Ransky3000/Automated-Voltage-Regulator-System/docs/Automated-Voltage-Regulator-System_Simulation/Voltage Regulator Actual picture/Front view.jpg

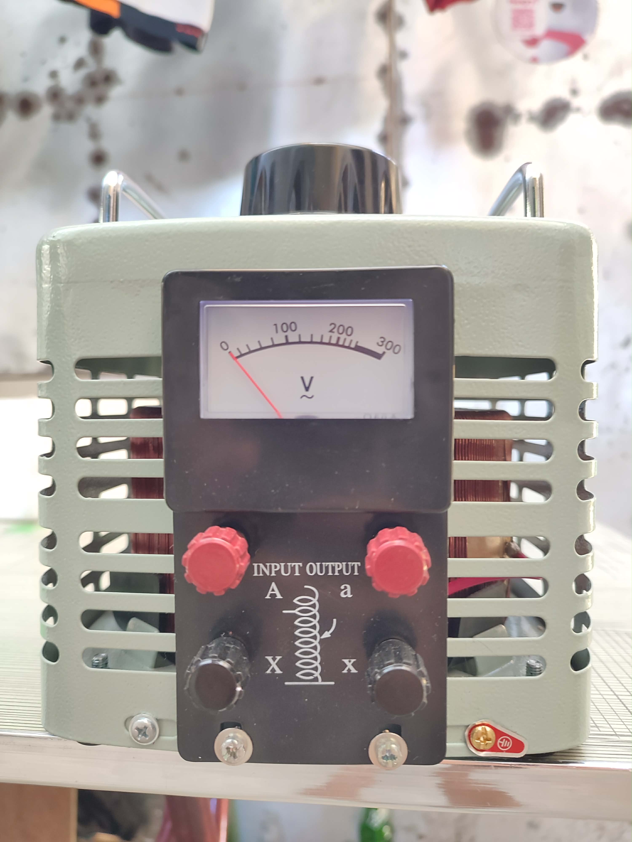
docs/Automated-Voltage-Regulator-System_Simulation/Voltage Regulator Actual picture/Front view.jpg
