Ransky3000/Automated-Voltage-Regulator-System/Option functions.pdf

Okay this is the overall system feature:

The First menu view on LCD 16x2:

1. Home: First line "[A] Set Voltage", Second line "[B] View Status"
1.1. Inside option [A]: First line "[A] Set target output", Second line "[B] <e.g. 50>", then enter display transitions to “Target output 50V”, then directed to [1.2 ].
1.2. Inside option [B]:First line "[A] Input", Second line "[B] Output"
1.2.1. Inside option [A]: First line "Voltage: <e.g 48V>”(Displays live voltage Input), 2nd line blank
1.2.2. Inside option [B]: First line "V: <e.g. 51V> I: <e.g. 5A>”, 2nd line “P: e.g. 255W”

NOTE: Key ‘A’ for next/enter/confirm and Key ‘D’ to go back on previous option in case you input wrong.
