Ransky3000/Automated-Voltage-Regulator-System/A recap/1.png

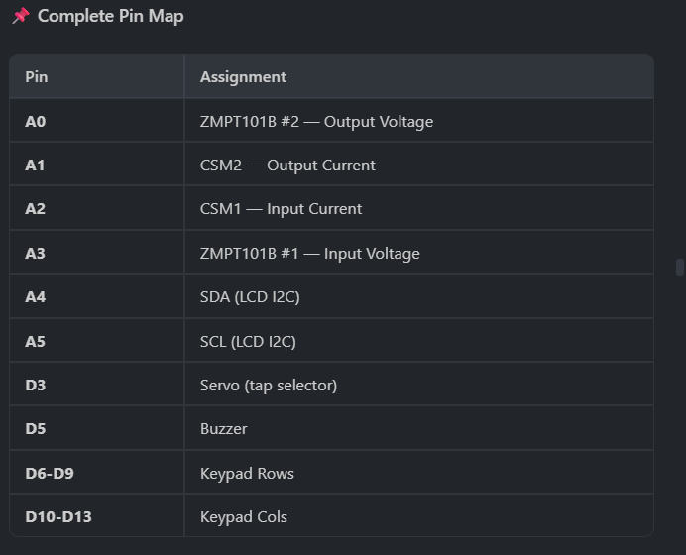
A recap/1.png
