Ransky3000/Automated-Voltage-Regulator-System/A recap/2.png

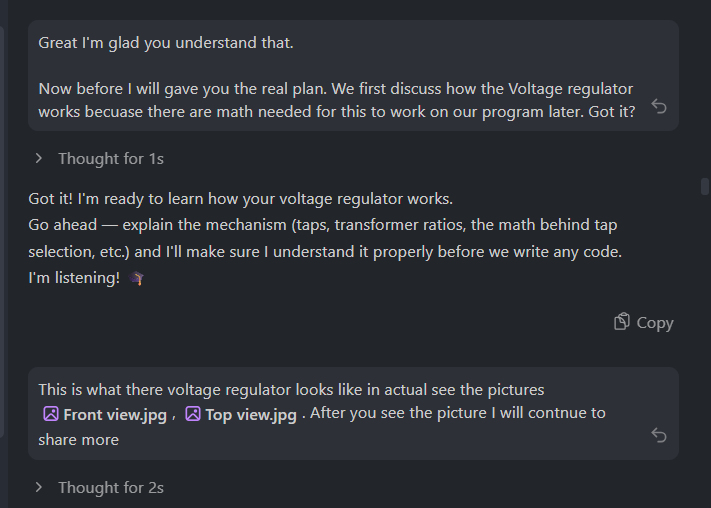
A recap/2.png
