Ransky3000/Automated-Voltage-Regulator-System/A recap/3.png

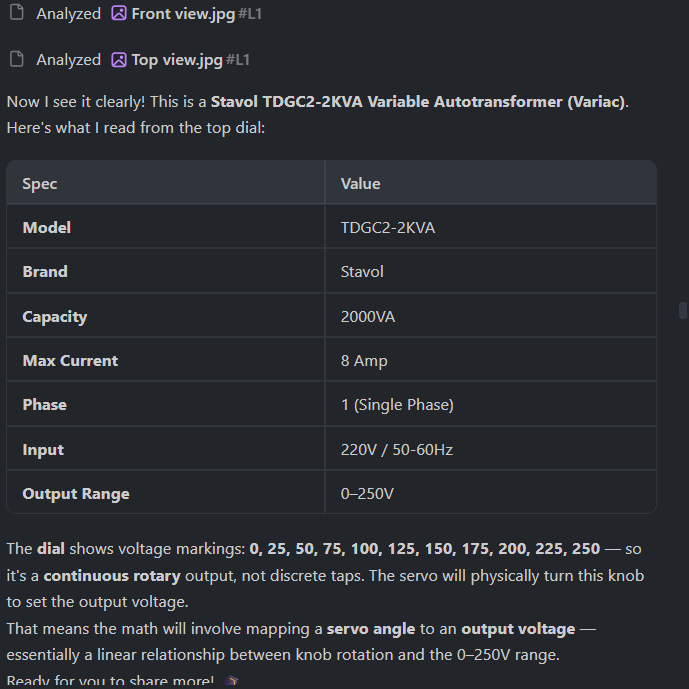
A recap/3.png
