Ransky3000/Automated-Voltage-Regulator-System/A recap/4.png

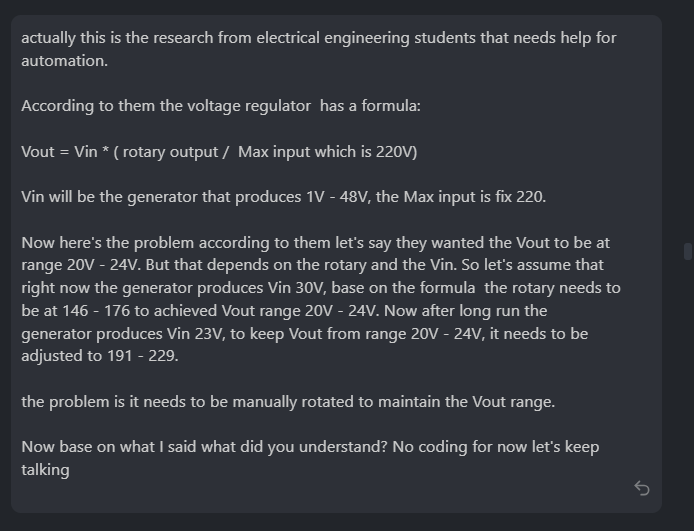
A recap/4.png
