Ransky3000/Automated-Voltage-Regulator-System/A recap/5.png

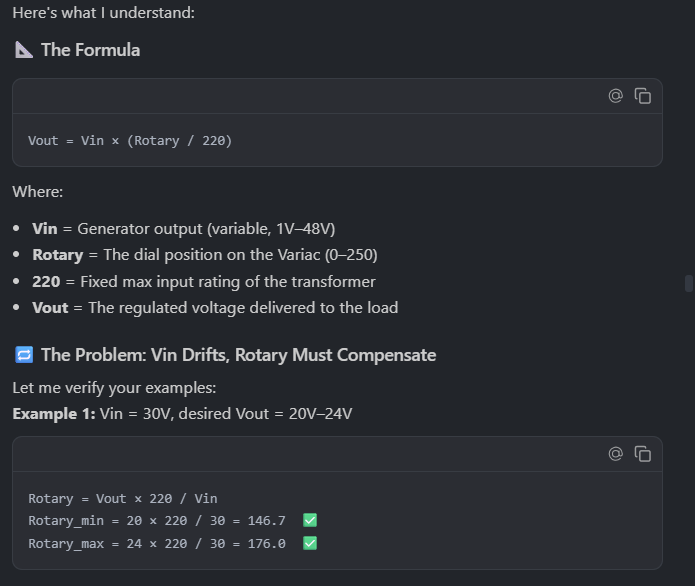
A recap/5.png
