Ransky3000/Automated-Voltage-Regulator-System/A recap/6.png

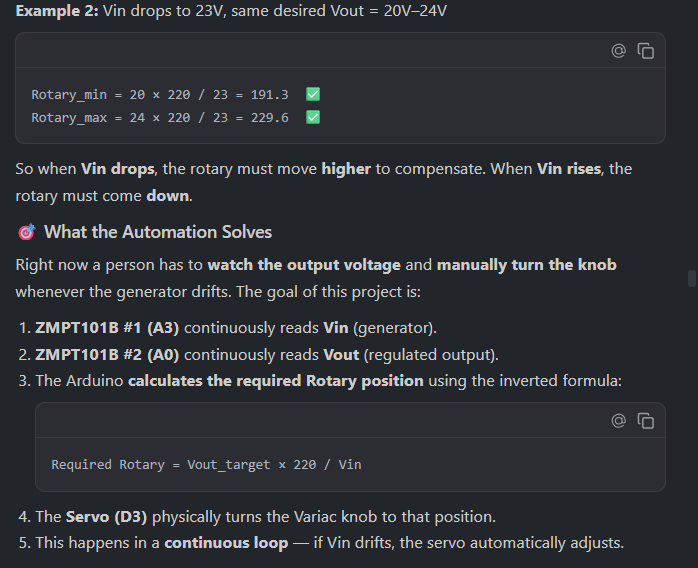
A recap/6.png
