Ransky3000/Automated-Voltage-Regulator-System/A recap/7.png

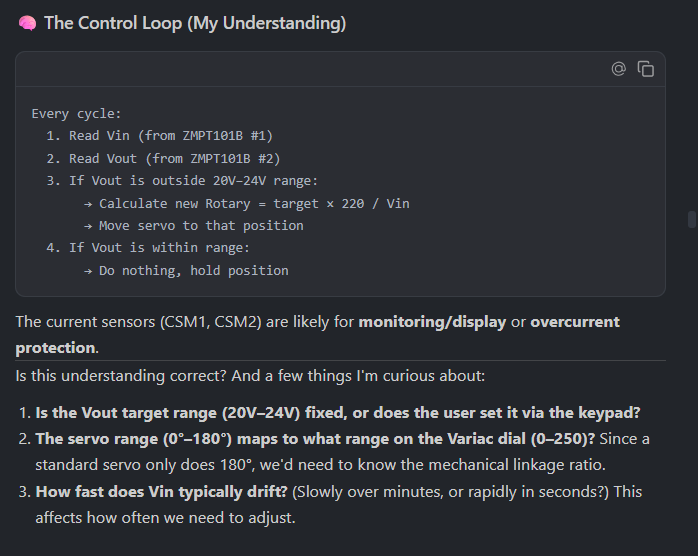
A recap/7.png
