Ransky3000/Automated-Voltage-Regulator-System/A recap/8.png

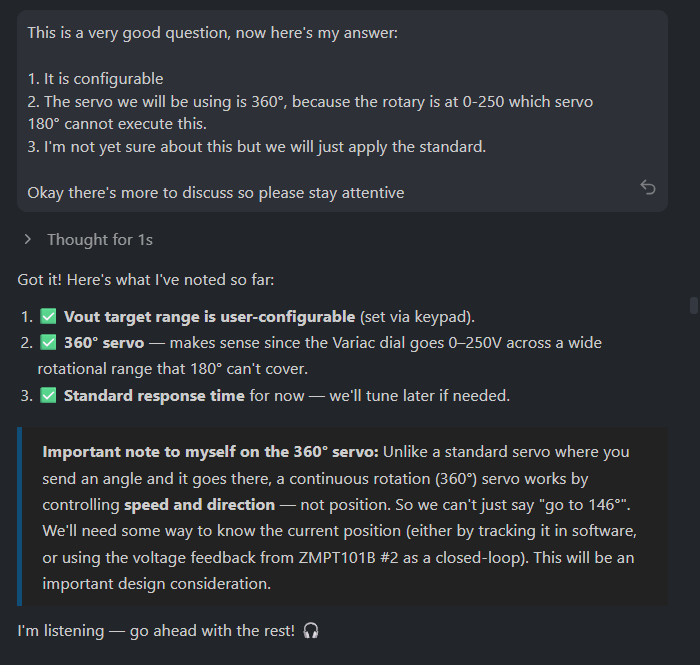
A recap/8.png
