Ransky3000/Automated-Voltage-Regulator-System/A recap/9.png

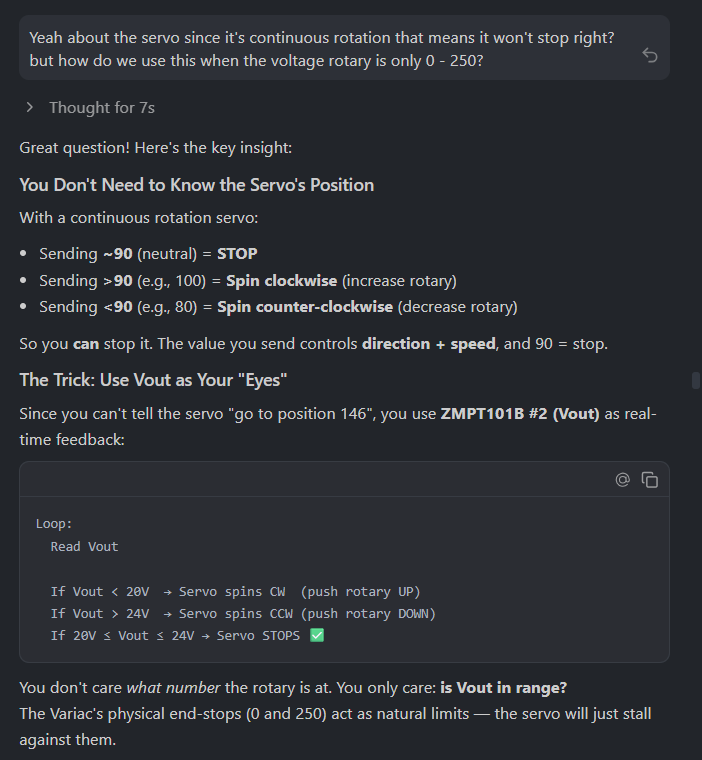
A recap/9.png
