Ransky3000/Automated-Voltage-Regulator-System/A recap/10.png

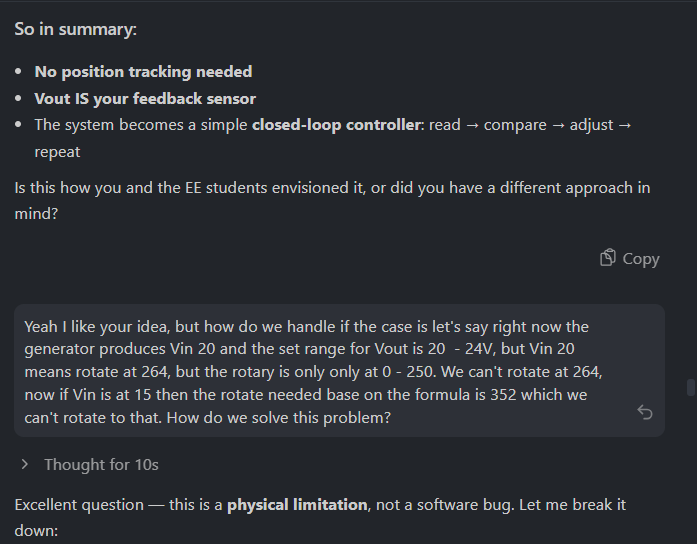
A recap/10.png
