Ransky3000/Automated-Voltage-Regulator-System/A recap/11.png

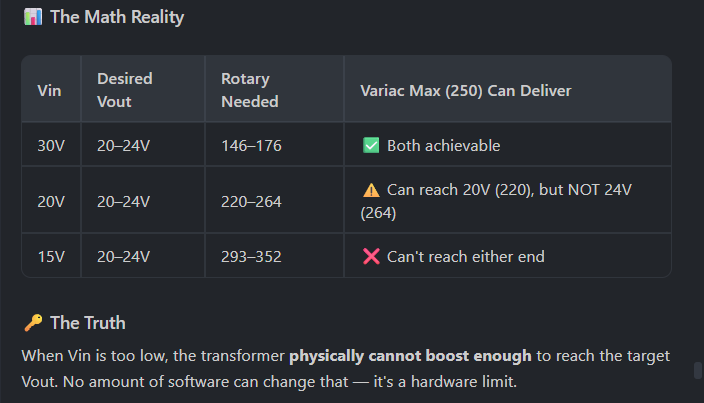
A recap/11.png
