Ransky3000/Automated-Voltage-Regulator-System/A recap/12.png

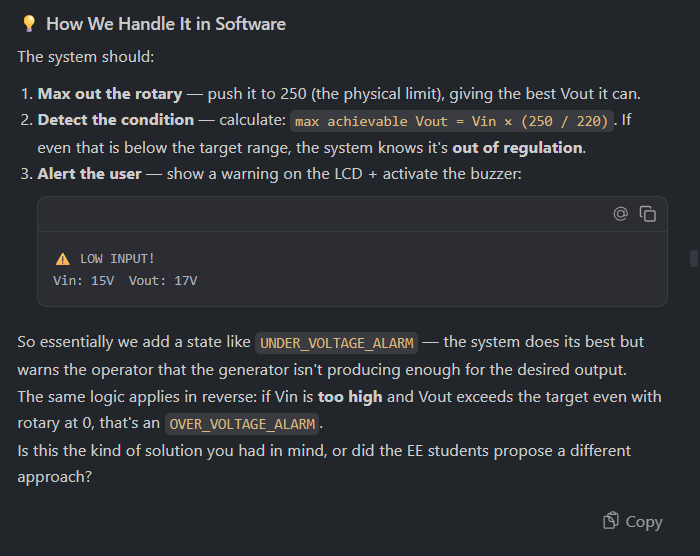
A recap/12.png
