Ransky3000/Automated-Voltage-Regulator-System/A recap/13.png

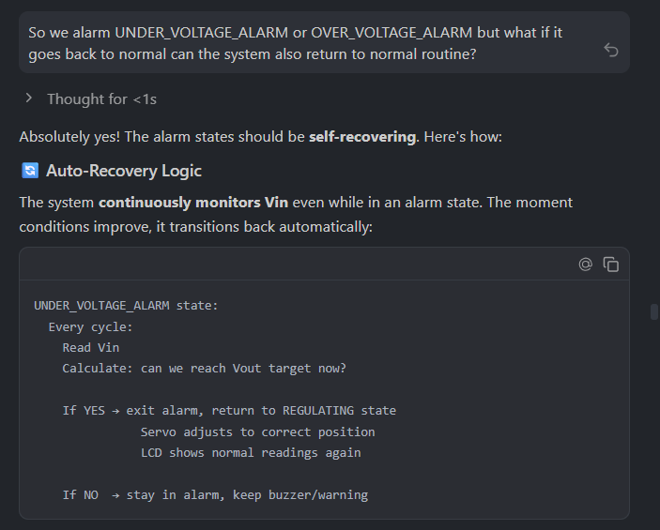
A recap/13.png
