Ransky3000/Automated-Voltage-Regulator-System/A recap/14.png

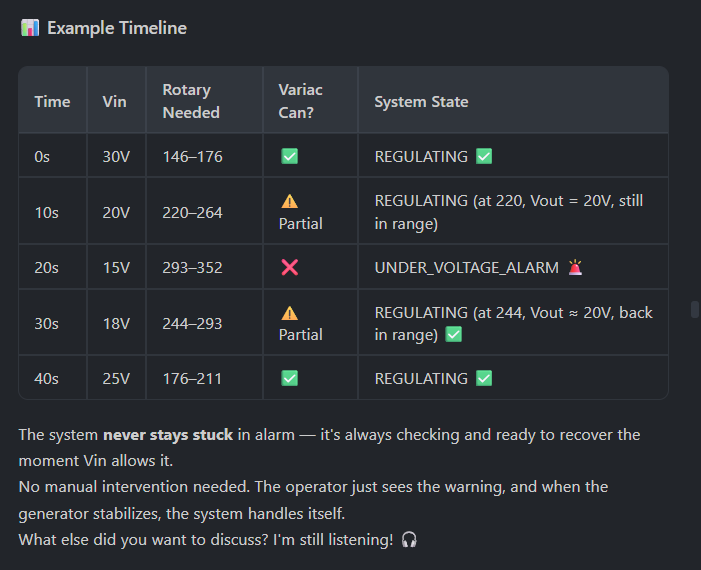
A recap/14.png
