Ransky3000/Automated-Voltage-Regulator-System/A recap/15.png

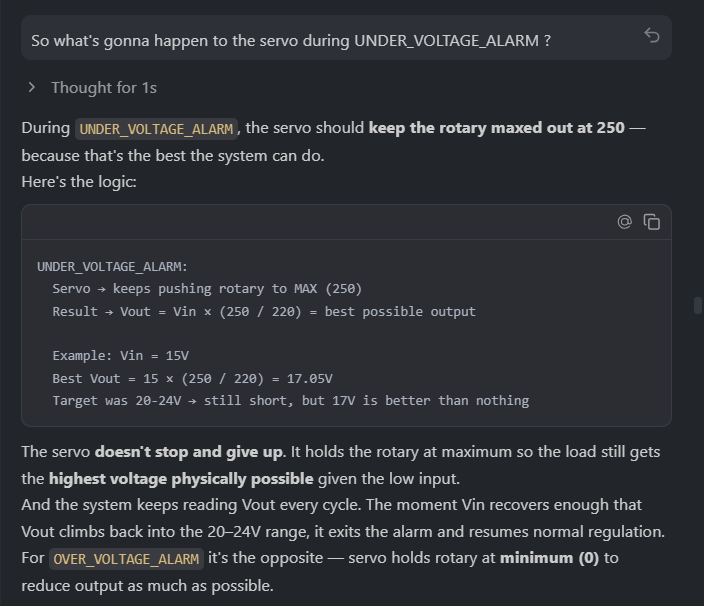
A recap/15.png
