Ransky3000/Automated-Voltage-Regulator-System/A recap/16.png

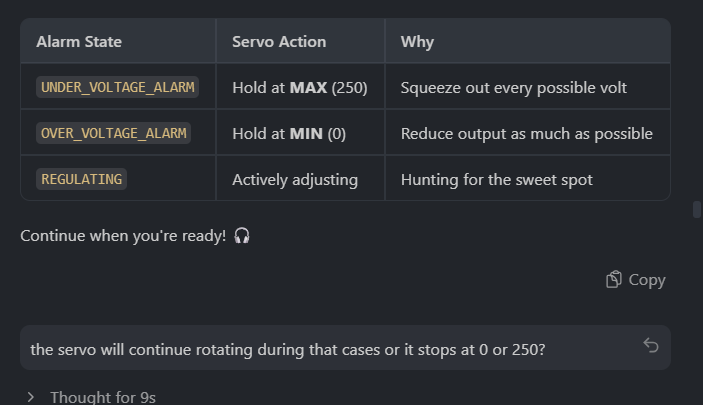
A recap/16.png
