Ransky3000/Automated-Voltage-Regulator-System/A recap/17.png

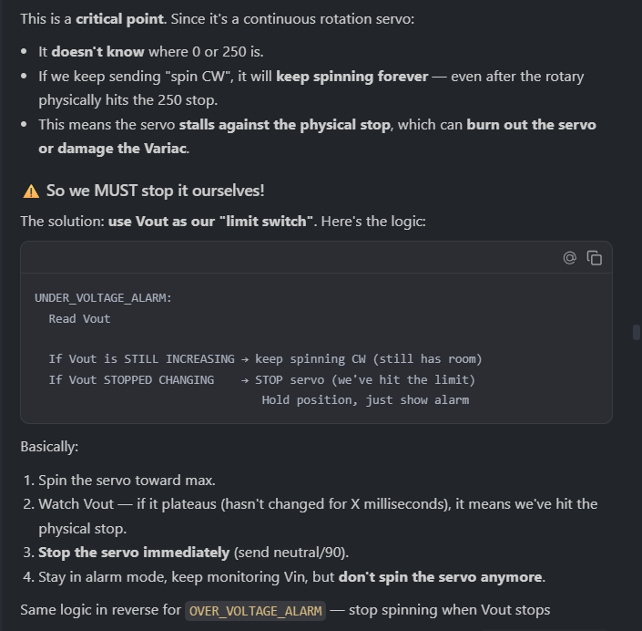
A recap/17.png
