Ransky3000/Automated-Voltage-Regulator-System/A recap/18.png

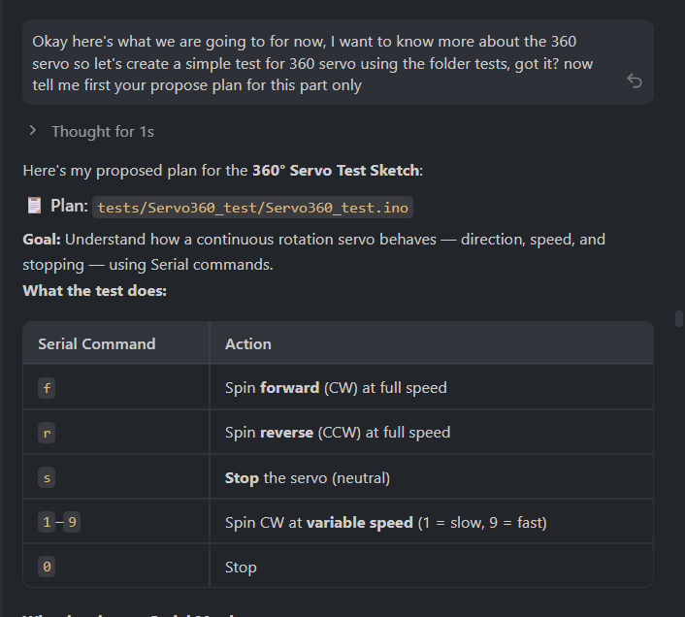
A recap/18.png
