Ransky3000/Automated-Voltage-Regulator-System/docs/Automated-Voltage-Regulator-System_Simulation/Screenshots/Full view.png

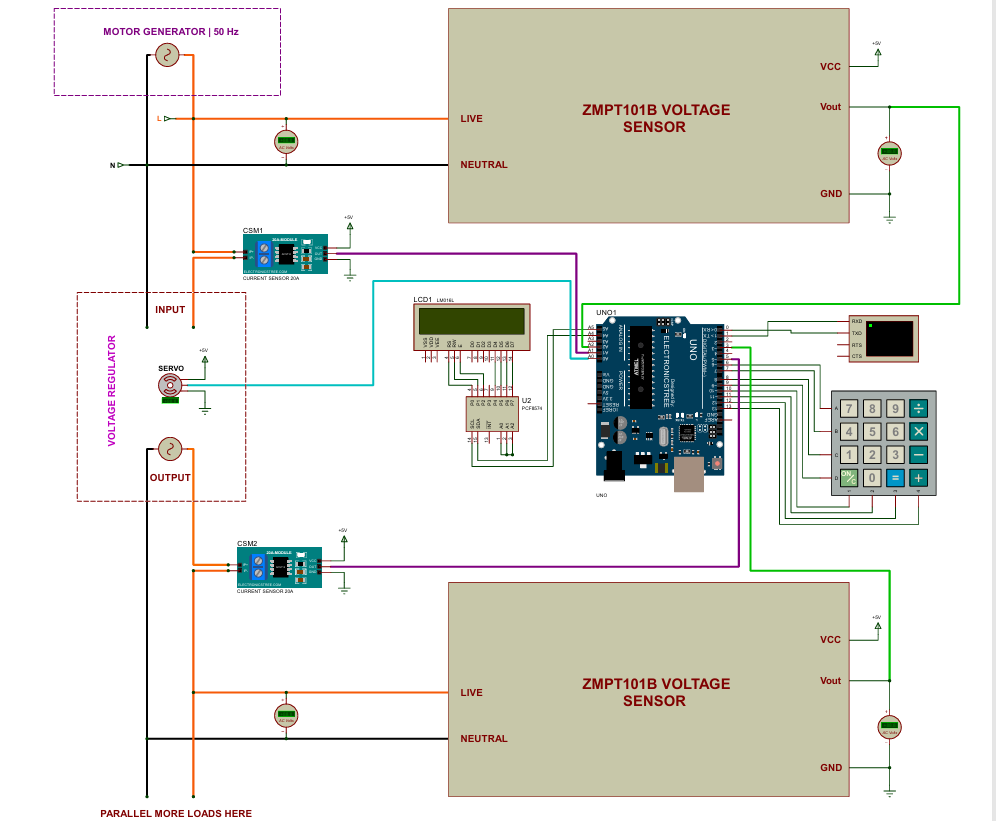
docs/Automated-Voltage-Regulator-System_Simulation/Screenshots/Full view.png
