Ransky3000/Automated-Voltage-Regulator-System/docs/Automated-Voltage-Regulator-System_Simulation/Screenshots/Mid layer.png

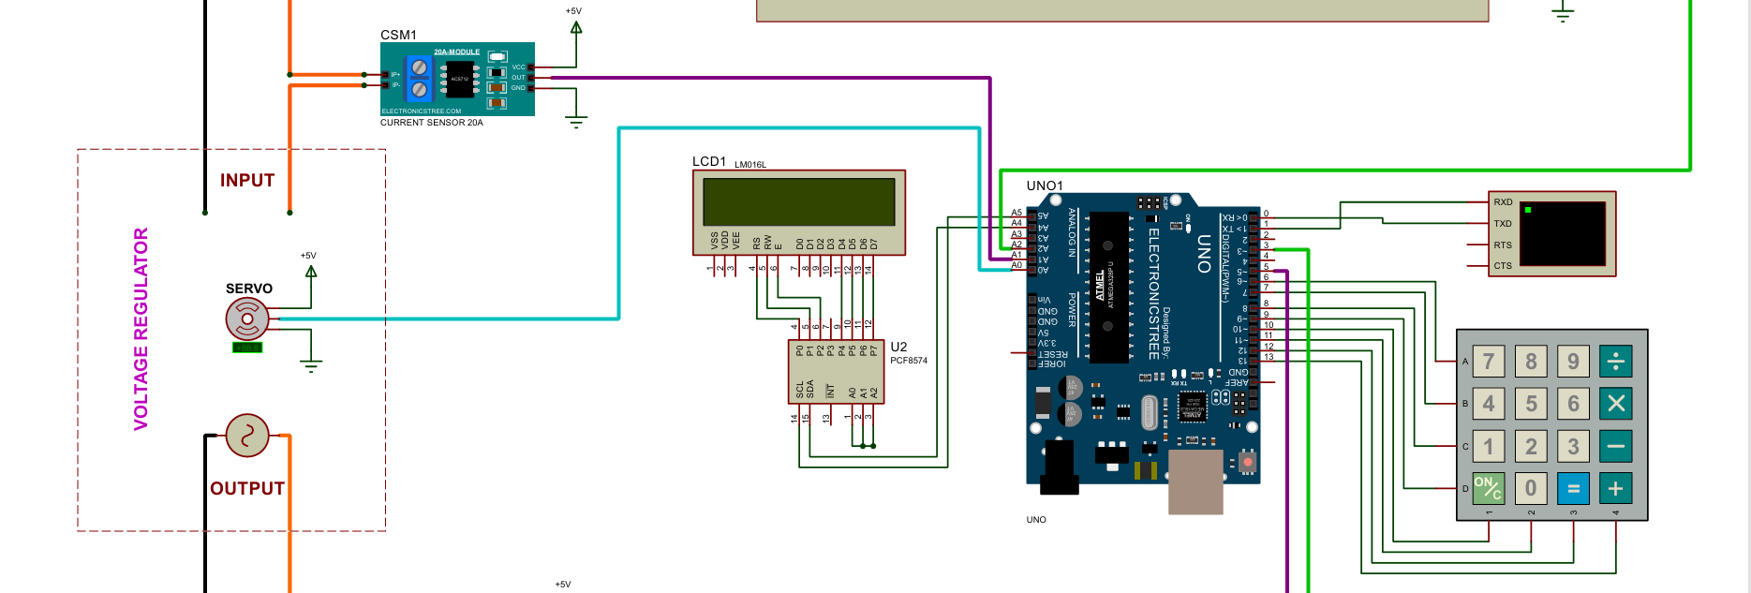
docs/Automated-Voltage-Regulator-System_Simulation/Screenshots/Mid layer.png
