Ransky3000/Automated-Voltage-Regulator-System/docs/Automated-Voltage-Regulator-System_Simulation/Voltage_regulator_Full_circuit.PDF

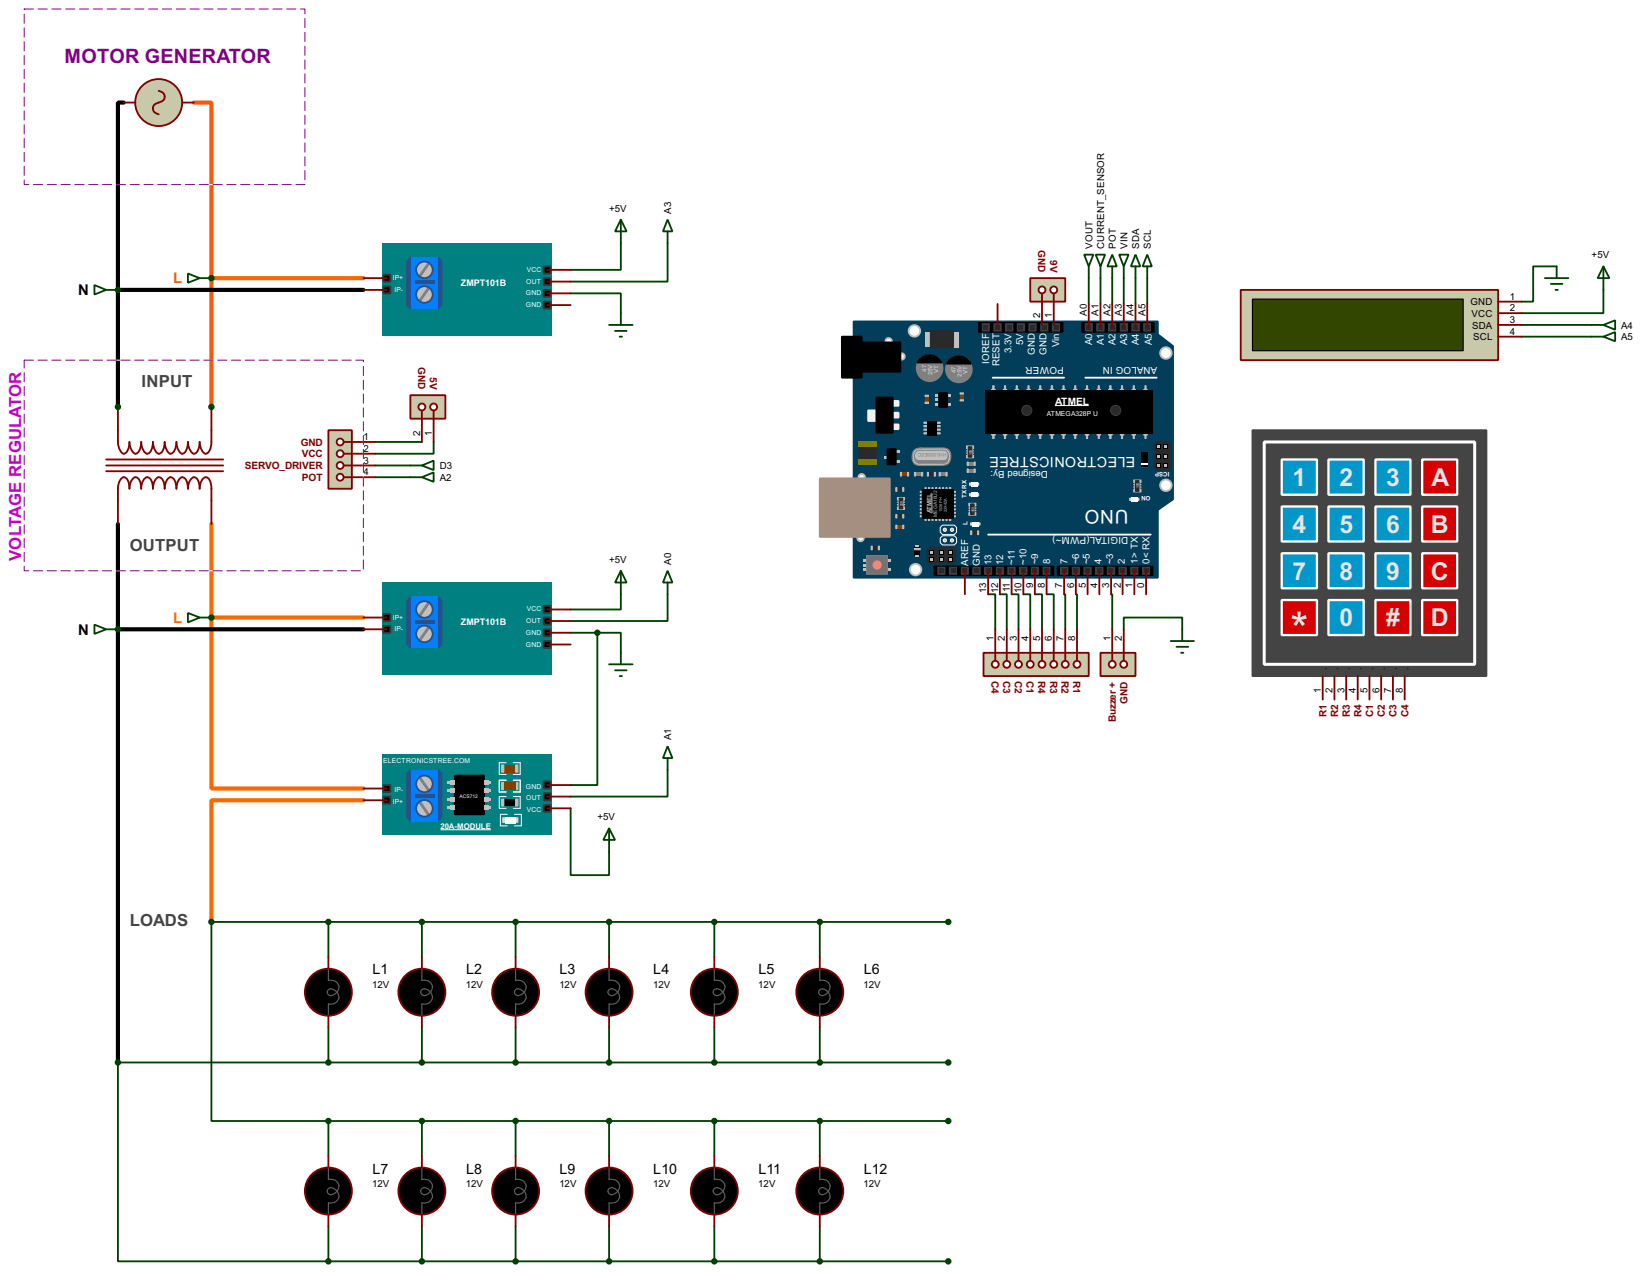
[picture p25: page 1]

VCC OUT GND GND
