Ransky3000/Automated-Voltage-Regulator-System/docs/Automated-Voltage-Regulator-System_Simulation/Automated-Voltage-Regulator-System_ACTUAL_CIRCUIT.PDF

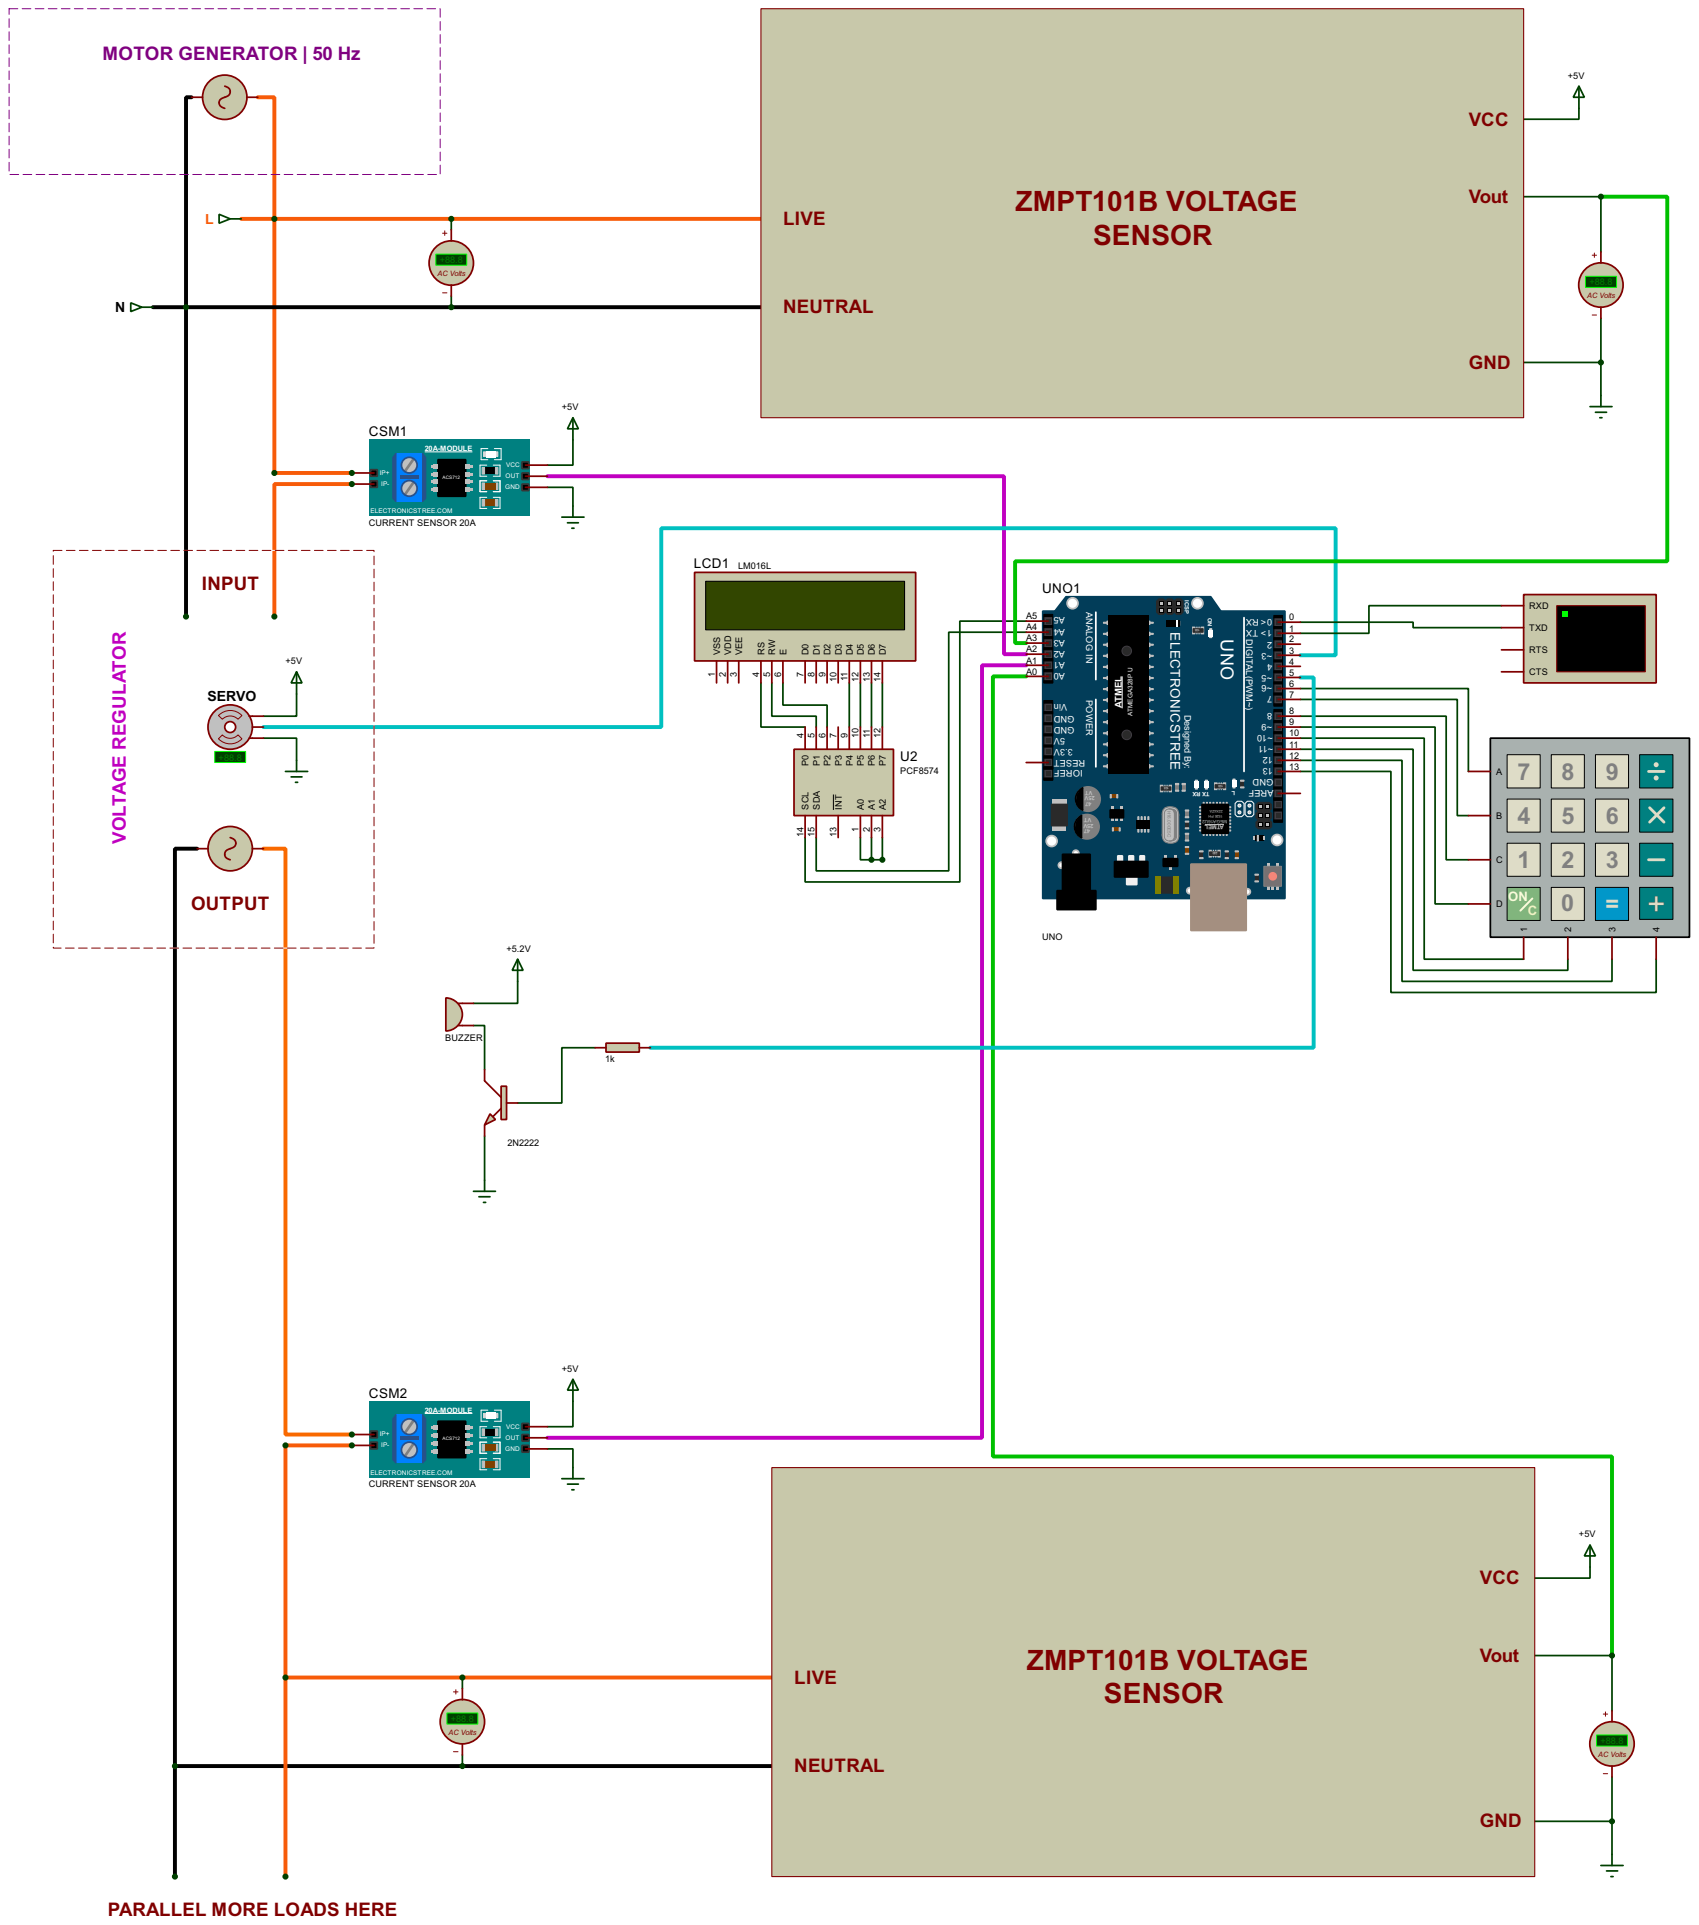
[picture p26: page 1]

ANALOG IN POWER 74V52 TV

10
11

PARALLEL MORE LOADS HERE
