Ransky3000/Automated-Voltage-Regulator-System/docs/Voltage_regulator_Actual_circuit.PDF

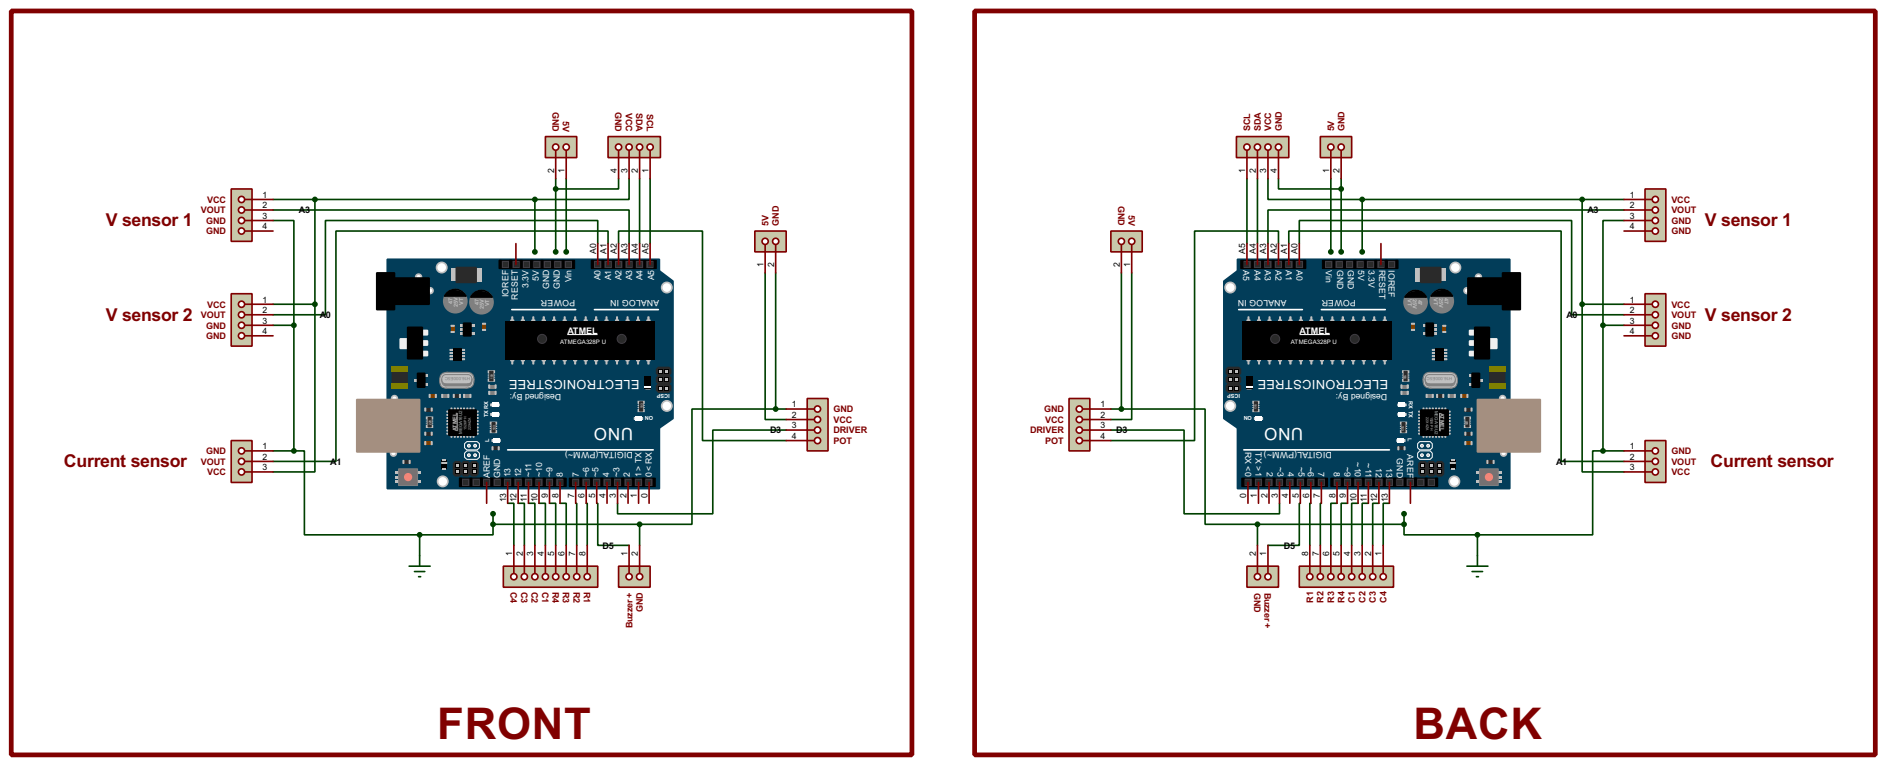
[picture p27: page 1]
