Ransky3000/Automated-Voltage-Regulator-System/docs/ZMPT101B_sensor_Simulation/zmpt101b.PDF

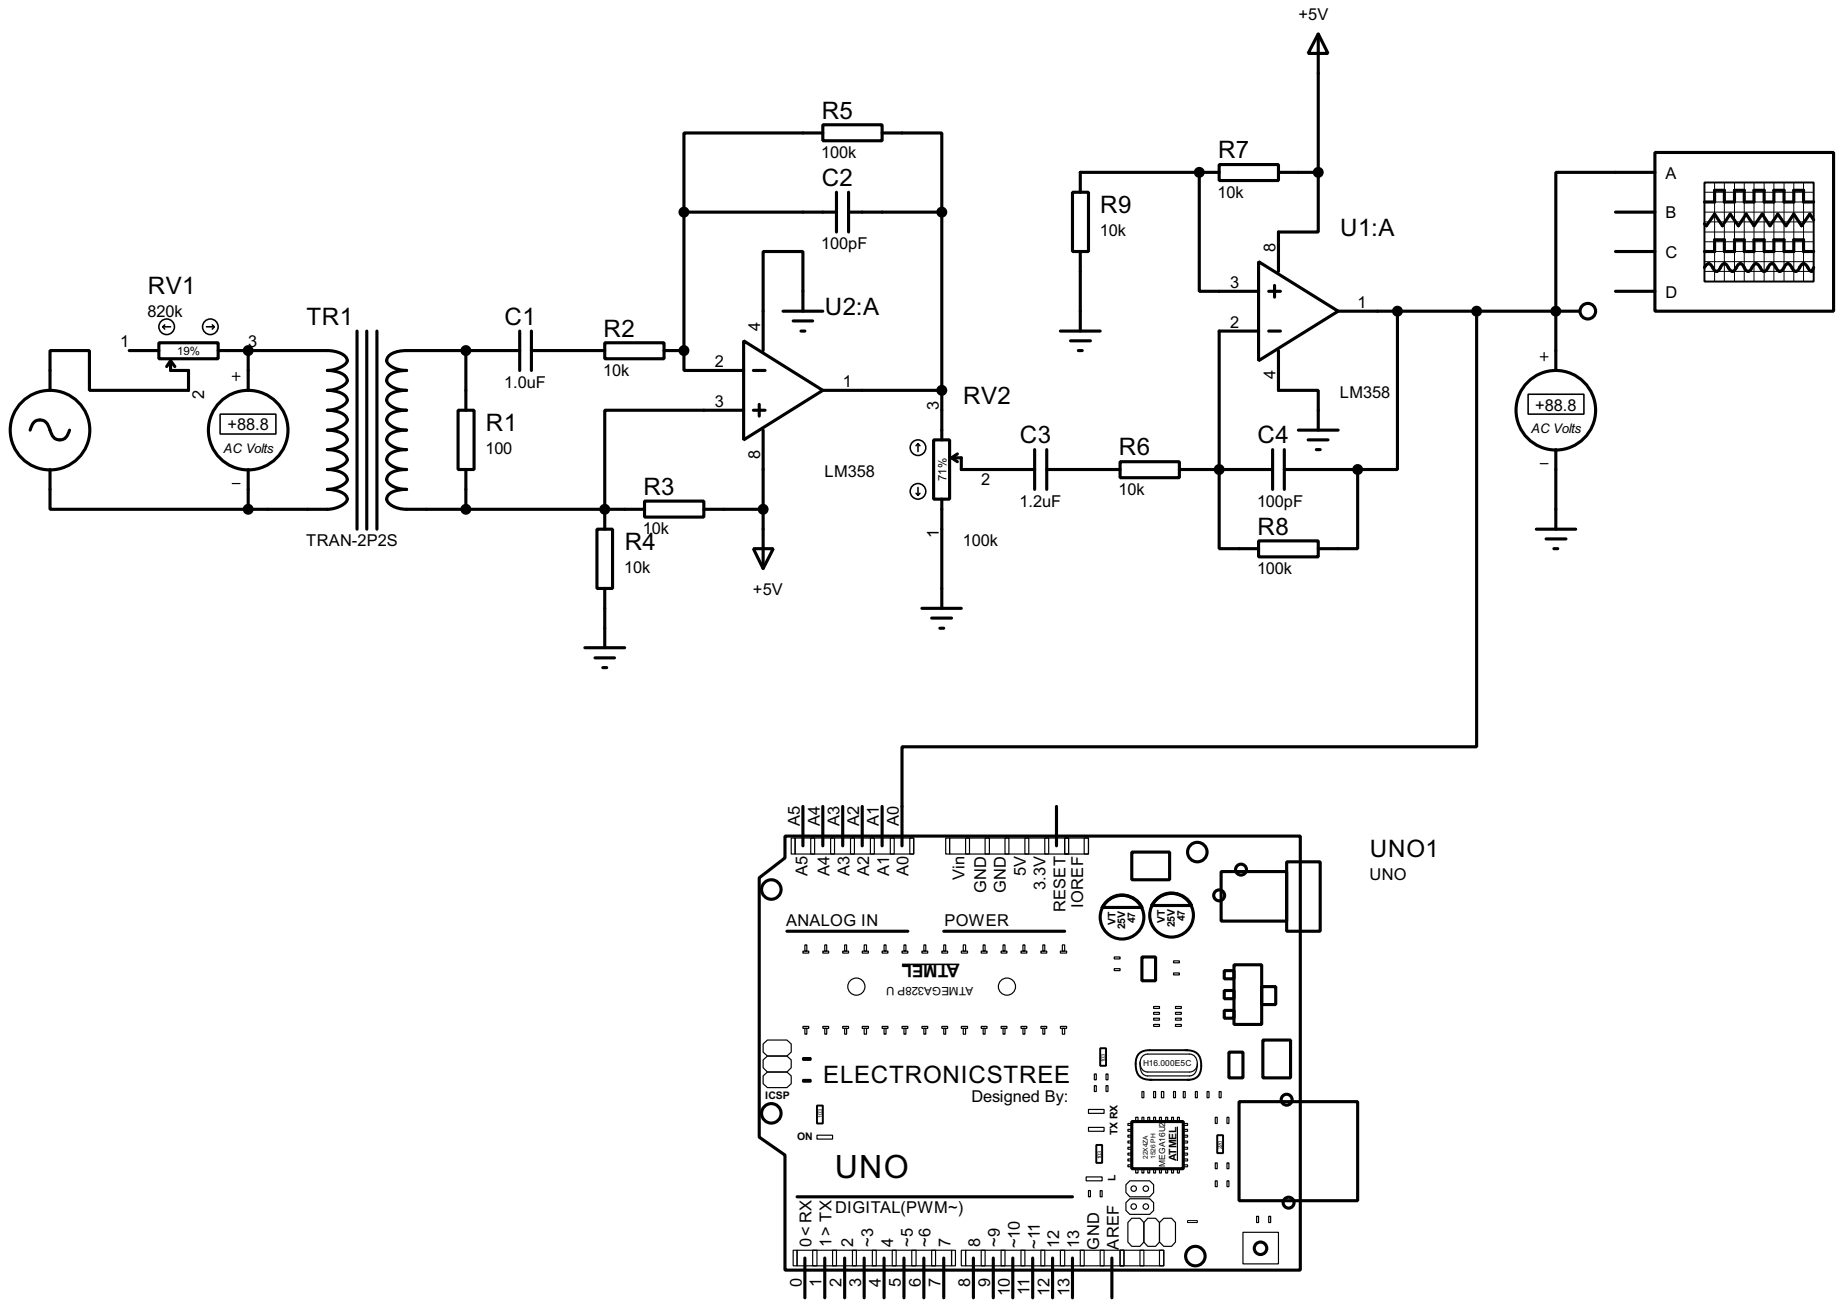
[picture p46: page 1]
