Ransky3000/Automated-Voltage-Regulator-System/(list of files, drawings)

Other design files:
docs/ZMPT101B_sensor_Simulation/zmpt101b.pdsprj
