Ransky3000/Automated-Voltage-Regulator-System/(commit log)

2026-02-11 feat: Add ZMPT101B AC voltage sensor driver with non-blocking RMS measurement, calibration, documentation, and a test sketch.
2026-02-12 feat: Add ZMPT101B voltage sensor driver with non-blocking RMS measurement capabilities.
2026-02-12 feat: Implement Hybrid ZMPT101B Driver (Blocking + Non-Blocking)
2026-02-12 feat: Implement core application logic with a new `Machine` class, update README for application firmware, and add ZMPT101B sensor simulation.
    [zmpt101b.pdsprj]
2026-02-16 feat: Add Proteus simulation projects and a non-blocking ZMPT101B sensor test sketch.
    [Automated-Voltage-Regulator-System_Simulation.pdsprj, zmpt101b.pdsprj]
2026-02-27 refactor: Restructure project, add Machine skeleton, exclude Proteus files
    [Automated-Voltage-Regulator-System_Simulation.pdsprj]
2026-02-28 docs: Add actual circuit diagram PDF and ignore `Projects_we_made` directory.
2026-02-28 feat: Add actual circuit diagram PDF and significantly expand the README with a detailed project overview, directory structure, and development guide.
2026-03-01 Add servo test sketches for Variac auto-positioning system
    - Add Servo360_test: basic continuous rotation servo tester (speed, direction, stop via Serial)
    - Add ServoPotFeedback_test: reads modified MG996R internal potentiometer on A2 while spinning
    - Add ServoMap_test: maps POT range (0-670) to Variac voltage (0-250V) with physical limit stops
    - Add ServoCalibration_test: guided 11-point calibration wizard for accurate POT-to-Voltage mapping
    - Add ServoAutoPosition_test: pulse-and-wait auto-positioning with proportional speed, detach idle, and direction-aware safety limits
    - Add circuit screenshots and voltage regulator actual pictures to docs
    - Update circuit PDF
2026-03-16 Implement Machine class with full voltage regulator control logic
    - Add Machine.h with triple-state architecture (UIState, RegulatorState, ServoState)
    - Add Machine.cpp with LCD menu system (HOME, INPUT_TARGET, VIEW_STATUS, VIEW_INPUT, VIEW_OUTPUT)
    - Add keypad input handling with A=confirm, D=back, *=backspace and ___V formatting
    - Port servo pulse-and-wait control loop from ServoAutoPosition_test with proportional speed
    - Add EEPROM 51-point calibration loading with interpolation for accurate dial positioning
    - Add ACS712 20A current sensor reading and power calculation (V x I) on VIEW_OUTPUT
    - Add stall-based alarm detection (UNDER_VOLTAGE / OVER_VOLTAGE) with auto-recovery
    - Add directio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
    [CCU_Master_Firmware.cpp, CCU_Master_Firmware.h, Machine.cpp, Machine.h, ServoAutoPosition_test.ino, __main__.ino]
2026-03-28 not stable
    [zmpt101b.pdsprj]
2026-03-29 No longer use fix position, it's Vout base knob adjustment
    [AdvancedCalibration.ino, Machine.cpp, Machine.h, Non-blocking_test.ino, NonBlockingAC.ino]
